andrenho-electronics/z80_aw/images/boards.jpg

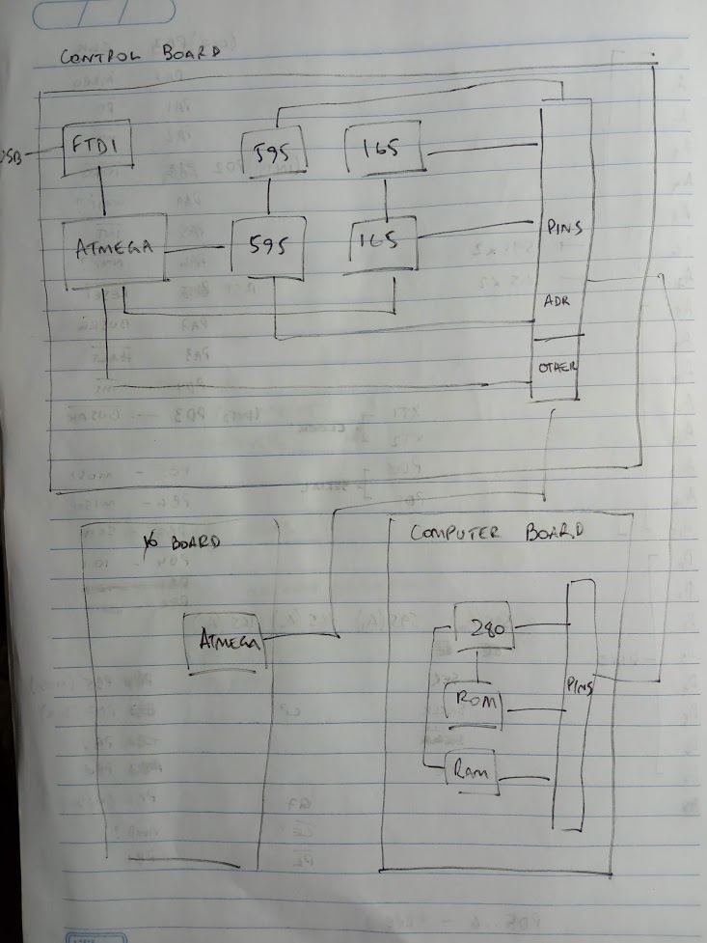
images/boards.jpg
