andrenho-electronics/z80_aw/images/pins.jpg

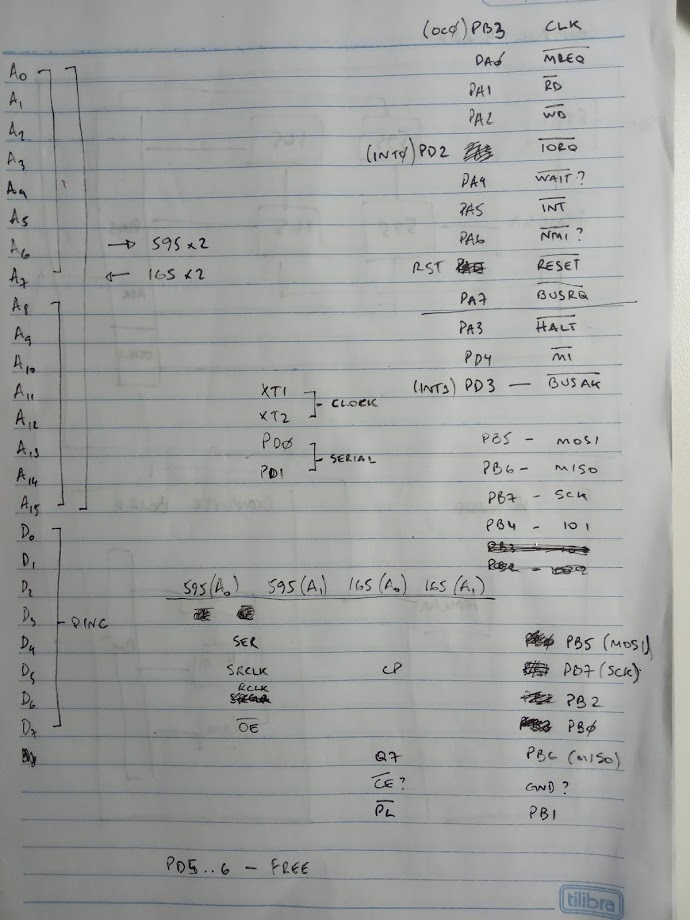
images/pins.jpg
