andrenho-electronics/z80_aw/tmp/main.c

#include <stdio.h>
#include <avr/pgmspace.h>
#include <util/delay.h>

#include "serial.h"
#include "sdcard.h"

static void print_byte(uint16_t idx, uint8_t byte, void* data)
{
    (void) idx; (void) data;
    printf_P(PSTR("%02X "), byte);
}

static uint8_t data_to_write(uint16_t idx, void* data)
{
    (void) data;
    return (idx + 5) & 0xff;
}

static void print_last_response()
{
    printf_P(PSTR("%02X %02X\r\n"), sdcard_last_stage(), sdcard_last_response().value);
}

int main()
{
    serial_init();

    printf_P(PSTR("\e[1;1H\e[2J"));  // clear screen

    printf_P(PSTR("Initializing SD card... "));
    bool ok = sdcard_init();
    print_last_response();
    if (!ok)
        for(;;);

    /*
    printf_P(PSTR("Writing to SD card (block 1)... "));
    ok = sdcard_write_block(1, data_to_write, NULL);
    printf_P(PSTR("\r\nResponse: "));
    print_last_response();
    if (!ok)
        for (;;);

    */
    for (int i = 0; i < 1; ++i) {
        printf_P(PSTR("Reading from SD card (block %d)... "), i);
        ok = sdcard_read_block(i, print_byte, NULL);
        printf_P(PSTR("\r\nResponse: "));
        print_last_response();
        if (!ok)
            for (;;);
    }

    printf_P(PSTR("OK"));
    for(;;);
}

/*
#define reverse_bytes_32(num) ( ((num & 0xFF000000) >> 24) | ((num & 0x00FF0000) >> 8) | ((num & 0x0000FF00) << 8) | ((num & 0x000000FF) << 24) )

static void print_r1(R1 r1)
{
    printf("(%02X) ", r1.value);
    if (r1.value == 0xff) {
        printf_P(PSTR("general error "));
        return;
    }
    if (r1.r1.idle)
        printf_P(PSTR("idle "));
    if (r1.r1.erase_reset)
        printf_P(PSTR("erase_reset_err "));
    if (r1.r1.illegal_cmd)
        printf_P(PSTR("illegal_cmd "));
    if (r1.r1.crc_error)
        printf_P(PSTR("crc_error "));
    if (r1.r1.erase_seq)
        printf_P(PSTR("erase_seq_err "));
    if (r1.r1.address_err)
        printf_P(PSTR("address_err "));
    if (r1.r1.param_err)
        printf_P(PSTR("param_err "));
    if (r1.value == 0)
        printf_P(PSTR("ok "));
    printf("\b");
}

static void print_r7(R7 r7)
{
    print_r1((R1) { r7.r7.r1 });
    printf_P(PSTR(" cmd_ver: %X, voltage: %X, check: %X "), r7.r7.cmd_version, r7.r7.voltage, r7.r7.check);
}

static void print_r3(R3 r3)
{
    print_r1((R1) { r3.r3.r1 });
    printf_P(PSTR(", "));
    uint32_t ocr = reverse_bytes_32(r3.r3.ocr);
    printf_P(PSTR("(%lX) "), ocr);
#define BIT(n, text) if (ocr & ((uint32_t) 1 << n)) printf_P(PSTR(text));
    BIT(31, "card_busy ");
    BIT(30, "high_capacity_card ");
    BIT(29, "uhs_ii_card_status ");
    BIT(24, "can_switch_to_1.8v ");
    BIT(15, "2.8_2.9v ");
    BIT(16, "2.9_3.0v ");
    BIT(17, "3.0_3.1v ");
    BIT(18, "3.1_3.2v ");
    BIT(19, "3.2_3.3v ");
    BIT(21, "3.3_3.4v ");
    BIT(22, "3.4_3.5v ");
    BIT(23, "3.5_3.6v ");
#undef BIT
}

int main()
{
    serial_init();

    printf_P(PSTR("\e[1;1H\e[2J"));  // clear screen

    printf_P(PSTR("SD card setup... "));
    sdcard_setup();
    printf_P(PSTR("done.\r\n"));

    printf_P(PSTR("SD card initialization..."));
    sdcard_initialize();
    printf_P(PSTR("done.\r\n"));

    printf_P(PSTR("SD card set SPI mode (expected 1): "));
    print_r1(sdcard_set_spi_mode());
    printf_P(PSTR(".\n\r"));

    printf_P(PSTR("SD card interface condition: "));
    print_r7(sdcard_if_cond());
    printf_P(PSTR(".\n\r"));

    printf_P(PSTR("SD card initialization process: \r\n"));
    for (int i = 0; i < 8; ++i) {
        printf_P(PSTR("Attempt %d/8: "), i+1);
        R1 r1 = sdcard_init_process();
        print_r1(r1);
        printf_P(PSTR(".\n\r"));
        uint8_t value = *(uint8_t*)&r1;
        if (value == 0)
            goto done;
        _delay_ms(200);
    }

    printf_P(PSTR("Error initializing card.\n\r"));
    for (;;);
done:
    printf_P(PSTR("Card initialized.\n\r"));

    printf_P(PSTR("SD card information: "));
    print_r3(sdcard_get_info());
    printf_P(PSTR(".\n\r"));

    uint8_t data[512];
    for (int i = 0; i < 512; ++i)
        data[i] = i & 0xff;
    printf_P(PSTR("Writing SD card block: "));
    print_r1(sdcard_write_block(0, data));
    printf_P(PSTR(".\n\r"));

    printf_P(PSTR("Reading SD card block: "));
    for (int i = 0; i < 512; ++i)
        data[i] = 0xff;
    print_r1(sdcard_read_block(0, data));
    printf_P(PSTR(".\n\r"));
    for (int i = 0; i < 0x20; ++i) {
        for (int j = 0; j < 0x10; ++j) {
            printf_P(PSTR("%02X "), data[i * 0x10 + j]);
        }
        printf_P(PSTR("\r\n"));
    }

    for (;;);
}
*/
