andrenho-electronics/z80_aw/firmware/dbg.c

#include "dbg.h"

#include <stddef.h>

#include "../common/protocol.h"
#include "buffer.h"
#include "breakpoints.h"
#include "io.h"
#include "memory.h"
#include "run.h"
#include "sdcard.h"
#include "serial.h"
#include "util.h"
#include "z80.h"

typedef enum { REGFETCH_DISABLED = 0, REGFETCH_NMI = 1, REGFETCH_EMULATOR = 2 } RegisterFetchMode;
RegisterFetchMode register_fetch_mode = REGFETCH_DISABLED;

static void send_registers(Z80_Registers const* r);

static void send_byte(uint16_t idx, uint8_t byte, void* data)
{
    (void) idx; (void) data;
    serial_send(byte);
}

void debugger_cycle()
{
    uint8_t c = serial_recv_noblock();

    switch (c) {
        case 0:
            break;

        // 
        // controller
        //

        case 'A':
            serial_send('a');   // this is for manual tests
            break;
        case Z_ACK_REQUEST:
            serial_send(Z_ACK_RESPONSE);
            break;
        case Z_CTRL_INFO:
            serial_send16(free_ram());
            break;
        case Z_EXIT_EMULATOR:  // command without effect
            serial_send(Z_OK);
            break;
        case Z_REGFETCH_MODE: {
                int m = serial_recv();
                if (m <= 2) {
                    register_fetch_mode = m;
                    serial_send(Z_OK);
                } else if (m == REGFETCH_EMULATOR) {
                    serial_send(Z_EMULATOR_ONLY);
                } else {
                    serial_send(Z_INVALID_CMD);
                }
            }
            break;
        case Z_REGISTERS:
            serial_send(Z_EMULATOR_ONLY);
            break;

        // 
        // memory
        //

        case Z_WRITE_BLOCK: {
                uint16_t addr = serial_recv16();
                uint16_t sz = serial_recv16();
                for (size_t i = 0; i < sz; ++i)
                    buffer[i] = serial_recv();
                uint16_t checksum;
                if (memory_write_page(addr, buffer, sz, &checksum))
                    serial_send(Z_OK);
                else
                    serial_send(Z_INCORRECT_BUS);
                serial_send16(checksum);
            }
            break;
        case Z_READ_BLOCK: {
                uint16_t addr = serial_recv16();
                uint16_t sz = serial_recv16();
                if (memory_read_page(addr, buffer, sz))
                    serial_send(Z_OK);
                else
                    serial_send(Z_INCORRECT_BUS);
                for (size_t i = 0; i < sz; ++i)
                    serial_send(buffer[i]);
            }
            break;

        //
        // cpu
        //

        case Z_POWERDOWN:
            z80_powerdown();
            serial_send(Z_OK);
            break;
        case Z_RESET:
            z80_reset();
            serial_send(Z_OK);
            break;
        case Z_PC:
            serial_send16(z80_pc());
            break;
        case Z_STEP:
            if (register_fetch_mode == REGFETCH_DISABLED) {
                uint8_t printed_char = z80_step();
                serial_send(printed_char);
            } else {
                z80_step_debug();
                send_registers(z80_registers_last_update());
            }
            break;
        case Z_NEXT: {
                z80_next();
                serial_send(Z_OK);
            }
            break;
        case Z_KEYPRESS:
            z80_set_last_keypress(serial_recv());
            z80_interrupt(0xcf);   // RST 0x8  
            serial_send(Z_OK);
            break;
        case Z_RUN:
            run();
            break;
        case Z_NMI:
            z80_nmi();
            serial_send(Z_OK);
            break;

        //
        // breakpoints
        //

        case Z_ADD_BKP:
            if (bkp_add(serial_recv16()))
                serial_send(Z_OK);
            else
                serial_send(Z_TOO_MANY_BKPS);
            break;
        case Z_REMOVE_BKP:
            bkp_remove(serial_recv16());
            serial_send(Z_OK);
            break;
        case Z_REMOVE_ALL_BKPS:
            bkp_remove_all();
            serial_send(Z_OK);
            break;
        case Z_QUERY_BKPS: {
                uint16_t bkps[MAX_BREAKPOINTS];
                int count = bkp_query(bkps);
                serial_send(count);
                for (int i = 0; i < count; ++i)
                    serial_send16(bkps[i]);
            }
            break;

        //
        // continue
        //

        case Z_LAST_EVENT: {
                Z80_Event e = z80_last_event();
                serial_send(Z_OK);
                serial_send(e.last_printed_char);
                serial_send(e.bkp_hit);
                serial_send16(z80_pc());
            }
            break;

        case Z_CONTINUE:
            z80_continue();
            serial_send(Z_OK);
            return;

        case Z_STOP:
            z80_stop();
            serial_send(Z_OK);
            break;

        //
        // SD card
        //
        case Z_HAS_DISK:
            serial_send(sdcard_last_response().value != 0xff ? Z_OK : Z_NO_DISK);
            break;
        case Z_UPDATE_DISK:
            serial_send(Z_EMULATOR_ONLY);
            break;
        case Z_DISK_LAST_STATUS:
            serial_send(Z_OK);
            serial_send(sdcard_last_stage());
            serial_send(sdcard_last_response().value);
            break;
        case Z_READ_DISK: {
                uint32_t block = serial_recv24();
                serial_send(Z_OK);
                sdcard_read_block(block, send_byte, NULL);
            }
            break;
        case Z_WRITE_DISK:
            serial_send(Z_EMULATOR_ONLY);
            break;
        case Z_LOAD_BOOT:
            z80_powerdown();
            sdcard_load_boot();
            serial_send(Z_OK);
            break;

        // 
        // not matching
        //

        default:
            serial_send(Z_INVALID_CMD);
            break;
    }
}

static void send_registers(Z80_Registers const* r)
{
    serial_send(r->af >> 8);
    serial_send(r->af & 0xff);
    serial_send(r->bc >> 8);
    serial_send(r->bc & 0xff);
    serial_send(r->de >> 8);
    serial_send(r->de & 0xff);
    serial_send(r->hl >> 8);
    serial_send(r->hl & 0xff);
    serial_send(r->afx >> 8);
    serial_send(r->afx & 0xff);
    serial_send(r->bcx >> 8);
    serial_send(r->bcx & 0xff);
    serial_send(r->dex >> 8);
    serial_send(r->dex & 0xff);
    serial_send(r->hlx >> 8);
    serial_send(r->hlx & 0xff);
    serial_send(r->ix & 0xff);
    serial_send(r->ix >> 8);
    serial_send(r->iy & 0xff);
    serial_send(r->iy >> 8);
    serial_send(z80_pc() & 0xff);
    serial_send(z80_pc() >> 8);
    serial_send(r->sp & 0xff);
    serial_send(r->sp >> 8);
    serial_send(r->ir & 0xff);
    serial_send(r->ir >> 8);
    serial_send(r->halt);
    serial_send(0);  // TODO - last printed char
}

// vim:ts=4:sts=4:sw=4:expandtab
