andrenho-electronics/z80_aw/firmware/z80.c

#include "z80.h"

#include <stddef.h>

#include "breakpoints.h"
#include "memory.h"
#include "io.h"
#include "sdcard.h"

static uint16_t      pc = 0;
static uint8_t       last_printed_char = 0;
static uint8_t       last_keypress = 0;
static int           last_interrupt = -1;
static Z80_Mode      mode = M_DEBUG;
static uint32_t      cycle_number = 0;
static uint16_t      register_stack_location = 0;
static Z80_Registers registers = { 0 };
static bool          bkp_hit = false;

static inline void z80_clock();

// 
// GETTERS/SETTERS
//

Z80_Event z80_last_event()
{
    Z80_Event e = {
        last_printed_char,
        bkp_hit,
    };
    last_printed_char = 0;
    bkp_hit = false;
    return e;
}

Z80_Mode z80_mode()
{
    return mode;
}

uint16_t z80_pc()
{
    return pc;
}

uint8_t z80_last_printed_char()
{
    return last_printed_char;
}

void z80_clear_last_printed_char()
{
    last_printed_char = 0;
}

void z80_set_last_keypress(uint8_t k)
{
    last_keypress = k;
}

Z80_Registers const* z80_registers_last_update()
{
    return &registers;
}

//
// I/O REQUEST, INTERRUPTS
//

void z80_nmi()
{
    set_NMI(0);
    z80_step();
    set_NMI(1);
}

static void z80_update_registers()
{
    uint8_t r[22];
    z80_busreq();
    if (!memory_read_page(register_stack_location, r, sizeof r)) {
        registers.ir = 0xffff;
        registers.iy = 0xffff;
        registers.ix = 0xffff;
        registers.hlx = 0xffff;
        registers.dex = 0xffff;
        registers.bcx = 0xffff;
        registers.afx = 0xffff;
        registers.hl = 0xffff;
        registers.de = 0xffff;
        registers.bc = 0xffff;
        registers.af = 0xffff;
        registers.sp = 0xffff;
    } else {
        registers.ir = r[0] | (r[1] << 8);
        registers.iy = r[2] | (r[3] << 8);
        registers.ix = r[4] | (r[5] << 8);
        registers.hlx = r[6] | (r[7] << 8);
        registers.dex = r[8] | (r[9] << 8);
        registers.bcx = r[10] | (r[11] << 8);
        registers.afx = r[12] | (r[13] << 8);
        registers.hl = r[14] | (r[15] << 8);
        registers.de = r[16] | (r[17] << 8);
        registers.bc = r[18] | (r[19] << 8);
        registers.af = r[20] | (r[21] << 8);
        registers.sp = register_stack_location + 0x18;
    }
}

static void z80_out(uint16_t addr, uint8_t data)
{
    if ((addr & 0xff) == 0x0) {     // video OUT (print char)
        last_printed_char = data;
    } else if ((addr & 0xff) == 0xfe) {  // load registers from stack - lower nibble
        register_stack_location = (register_stack_location & 0xff00) | data;
    } else if ((addr & 0xff) == 0xff) {  // load registers from stack - higher nibble
        register_stack_location = (data << 8) | (register_stack_location & 0xff);
        z80_update_registers();
    }
}

static uint8_t z80_in(uint16_t addr)
{
    if ((addr & 0xff) == 0x1) {     // keyboard IN (last key pressed)
        return last_keypress;
    }
    return 0;
}

void z80_check_iorq()
{
    if (get_IORQ() == 0) {
        uint16_t addr = memory_read_addr();
        if (get_WR() == 0) {  // OUT
            uint8_t data = memory_read_data();
            z80_out(addr, data);
        } else if (get_RD() == 0) {  // IN
            data_bus_takeover();
            memory_set_data(z80_in(addr));
        } else {  // INTERRUPT
            if (last_interrupt != -1) {
                data_bus_takeover();
                memory_set_data(last_interrupt);
                last_interrupt = -1;
                set_INT(1);
            }
        }
        while (get_IORQ() == 0)
            z80_clock();
        data_bus_release();
    }
}

void z80_interrupt(uint8_t vector)
{
    set_INT(0);
    last_interrupt = vector;
    z80_clock();
    z80_check_iorq();
}


//
// POWER
//

void z80_powerdown()
{
    set_ZRST(0);
    z80_clock();
}

void z80_reset()
{
    pc = 0;
    cycle_number = 0;

    set_BUSREQ(1);
    set_NMI(1);
    set_INT(1);
    memory_bus_release();

    set_ZRST(0);

    for (int i = 0; i < 50; ++i)
        z80_clock();
    
    set_ZRST(1);
    z80_step();
}

//
// STEP
//

static inline void z80_clock()
{
    set_ZCLK(1);
    set_ZCLK(0);
    ++cycle_number;
}

void z80_busreq()
{
    bool busack = 1;

    set_BUSREQ(0);
    while (busack == 1) {
        z80_clock();
        z80_check_iorq();
        busack = get_BUSACK();
    }
    set_BUSREQ(1);
}

uint8_t z80_step()
{
    if (mode == M_CONTINUE && (last_printed_char != 0 || bkp_hit))
        return 0;  // we wait until the last event is consumed by the client

    bool m1 = 1;

    uint8_t next_instruction;
    memory_read_page(pc, &next_instruction, 1);
    bool is_extended = (next_instruction == 0xcb || next_instruction == 0xdd || next_instruction == 0xed || next_instruction == 0xfd);

    // run cycle until M1
    set_BUSREQ(1);
    for (int i = 0; i < (is_extended ? 2 : 1); ++i) {
        m1 = 1;
        while (m1 == 1) {
            z80_clock();
            z80_check_iorq();
            m1 = get_M1();
        }
        if (is_extended)
            z80_clock();
    }
    pc = memory_read_addr();

    switch (mode) {
        case M_DEBUG:
            // run cycle until BUSACK
            if (mode == M_DEBUG)
                z80_busreq();
            break;
        case M_CONTINUE:
            // find out if breakpoint was hit
            if (bkp_in_list(pc)) {
                bkp_hit = true;
                mode = M_DEBUG;
                z80_busreq();
            }
            return 0;
    }

    uint8_t c = last_printed_char;
    last_printed_char = 0;
    return c;
}

void z80_step_debug()
{
    register_stack_location = 0;

    // send NMI
    z80_nmi();

    // run the whole subroutine until it reaches an RETN instruction
    uint8_t next_instruction[2];
    do {
        z80_step();
        memory_bus_takeover();
        memory_read_page(pc, next_instruction, 2);
        memory_bus_release();
    } while (next_instruction[0] != 0xed || next_instruction[1] != 0x45);  // ED4D = RETN
    z80_step();
    z80_step();
}

// 
// CONTINUE
//

void z80_next()
{
    uint8_t instruction;

    memory_read_page(pc, &instruction, 1);
    switch (instruction) {
        case 0xcd:  // CALL
        case 0xdc:
        case 0xfc:
        case 0xd4:
        case 0xc4:
        case 0xf4:
        case 0xec:
        case 0xe4:
        case 0xcc:
            bkp_add(pc + 3);
            mode = M_CONTINUE;
            break;
        default:
            z80_step();
            bkp_hit = true;
            break;
    }
}

void z80_continue()
{
    mode = M_CONTINUE;
}

void z80_stop()
{
    mode = M_DEBUG;
    z80_busreq();
}

// vim:ts=4:sts=4:sw=4:expandtab
