andrenho-electronics/z80_aw/debugger/args.h

#ifndef ARGS_H_
#define ARGS_H_

#include <stdbool.h>

typedef struct {
    const char* port;
    int         speed;
    bool        debug;
} Args;

Args parse_args(int argc, char* argv[]);

#endif

// vim:ts=4:sts=4:sw=4:expandtab
