andrenho-electronics/z80_aw/debugger/serial.c

#include "serial.h"

#include <stdbool.h>

#include <avr/interrupt.h>
#include <avr/io.h>
#include <stdio.h>
#include <stdlib.h>

void
ser_init()
{
    // set baud rate
    int ubrr = 12;  // 38400 at 8 Mhz - http://ruemohr.org/~ircjunk/avr/baudcalc/avrbaudcalc-1.0.8.php?postbitrate=38400&postclock=8
    UBRRH = (ubrr>>8);
    UBRRL = (ubrr);

    // set config
    UCSRC = (1<<URSEL) | (1<<UCSZ1) | (1<<UCSZ0);   // Async-mode 
    UCSRB = (1<<RXEN) | (1<<TXEN);     // Enable Receiver and Transmitter
}

void
ser_printchar(char c)
{
    while (!( UCSRA & (1<<UDRE))); // Wait for empty transmit buffer
    UDR = c;
}

void
ser_printstr(const char* text)
{
    for (int i = 0; text[i]; ++i)
        ser_printchar(text[i]);
}

void
ser_printhex(unsigned value, int digits)
{
    (void) digits;

    char out[10];
    snprintf(out, sizeof out, "%X\n\r", value);
    ser_printstr(out);
}

static void
input_buf(char* buf, size_t sz, bool echo)
{
    unsigned i = 0;
    do {
        while (!( UCSRA & (1<<RXC)));  // wait for empty receive buffer
        if (i < sz) {
            buf[i++] = UDR;
            if (echo)
                ser_printchar(buf[i-1]);
        }
    } while (buf[i-1] != '\r');
    if (echo)
        ser_printchar('\n');
}

char
ser_input(unsigned* data1, unsigned* data2, int* pars)
{
    char buf[24] = { 0 };
    input_buf(buf, sizeof buf, true);

    char command = 0;
    int n = sscanf(buf, "%c %x %x", &command, data1, data2);  // TODO - do this manually if there's no space in uc
    *pars = n - 1;
    if (command == 13 || command == 10)
        return 0;

    /*
    char b[30];
    snprintf(b, 30, "%d\n\r", command);
    ser_printstr(b);
    */
    
    return command;
}

uint8_t
ser_inputhex()
{
    char buf[24] = { 0 };
    input_buf(buf, sizeof buf, false);
    int data;
    sscanf(buf, "%x", &data);
    return (uint8_t) data;
}

// vim:ts=4:sts=4:sw=4:expandtab
