andrenho-electronics/z80_aw/debugger/ui.cc

#include "ui.hh"

#include "imgui/imgui_impl_glfw.h"
#include "imgui/imgui_impl_opengl3.h"

UI::UI(Window const& window)
    : io(init())
{
    ImGui_ImplGlfw_InitForOpenGL(window.ptr(), true);
    ImGui_ImplOpenGL3_Init("#version 130");
}

UI::~UI()
{
    ImGui_ImplOpenGL3_Shutdown();
    ImGui_ImplGlfw_Shutdown();
    ImGui::DestroyContext();
}

void UI::render()
{
    ImGui_ImplOpenGL3_NewFrame();
    ImGui_ImplGlfw_NewFrame();
    ImGui::NewFrame();
    draw();
    ImGui::Render();
}

void UI::render_draw()
{
    ImGui_ImplOpenGL3_RenderDrawData(ImGui::GetDrawData());
}

ImGuiIO& UI::init()
{
    IMGUI_CHECKVERSION();
    this->context = ImGui::CreateContext();
    return ImGui::GetIO();
}
